SavaMihnea/Security-System/firmware/central-unit/central-unit.ino

/**
 * =============================================================
 * VOXWALL Security System - Central Unit
 * Hardware: ESP32-S3 DevKit
 *
 * Responsibilities:
 *   - Receives sensor events from ESP32-C3 nodes via ESP-NOW
 *   - Forwards events to the Java backend over HTTPS
 *   - Controls siren via relay (GPIO)
 *   - Polls backend every 30 s to sync arm/disarm state
 *   - Runs AI deterrence conversation on alarm (Phase 6)
 *
 * Required libraries (Arduino Library Manager):
 *   - ArduinoJson      (Benoit Blanchon)
 *   - ESP32-audioI2S   (schreibfaul1)    <- for MP3 playback
 *
 * !! Before flashing: update WIFI_SSID, WIFI_PASSWORD,
 *    BACKEND_URL, and ESP_API_KEY below !!
 * =============================================================
 */

#include <WiFi.h>
#include <WiFiClientSecure.h>
#include <HTTPClient.h>
#include <esp_now.h>
#include <SPIFFS.h>
#include <driver/i2s.h>
#include <ArduinoJson.h>
#include "Audio.h"          // ESP32-audioI2S library

// ---- User configuration -----------------------------------------
const char* WIFI_SSID     = "DIGI-2eS3";
const char* WIFI_PASSWORD = "6bZ93ey3tJ";
const char* BACKEND_URL   = "https://voxwall-security.com"; // No trailing slash
const char* ESP_API_KEY   = "pFTF3EJ3MEKx0NE5sO1tAGouPNNeYwJ5CsPAg2zVUXgjevad";
// -----------------------------------------------------------------

// ---- GPIO pins --------------------------------------------------
#define RELAY_SIREN_PIN   10    // Active-LOW relay -> siren
#define RELAY_AUX_PIN     11    // Spare relay
#define RELAY_ON  LOW           // Most relay modules trigger on LOW
#define RELAY_OFF HIGH          // HIGH = relay released (siren off)
#define STATUS_LED_PIN     2    // Status LED

// I2S - MAX98357A amplifier (speaker output, used by ESP32-audioI2S - I2S_NUM_0)
#define I2S_SPK_BCLK     12
#define I2S_SPK_LRC      13
#define I2S_SPK_DOUT     14

// I2S - INMP441 microphone (input, manual driver - I2S_NUM_1)
#define I2S_MIC_SCK       5
#define I2S_MIC_WS        4
#define I2S_MIC_SD        6
// -----------------------------------------------------------------

// ---- Timing constants -------------------------------------------
#define HEARTBEAT_INTERVAL_MS    10000UL  // Sync backend every 10 s (arm mode changes reflect quickly)
#define ENTRY_DELAY_MS           10000UL  // 10 s entry delay for ARMED_AWAY
#define HOME_ENTRY_DELAY_MS       5000UL  // 5 s entry delay for ARMED_HOME (awake, can react faster)
#define PROACTIVE_INTERVAL_MS    12000UL  // Proactive statement every 12 s regardless of mic
#define MIC_RECORD_DURATION_MS    2500UL  // Record 2.5 s per AI interaction (faster response cycle)
#define MIC_AMPLITUDE_THRESHOLD   20000   // Raw I2S peak above = "sound detected"
#define MIC_SAMPLE_RATE           16000   // Hz (Whisper requirement)
// -----------------------------------------------------------------

// ---- Arm mode enum (mirrors backend SystemConfig.ArmMode) -------
enum ArmMode {
    DISARMED,
    ARMED_HOME,         // No sensors processed (home, awake)
    ARMED_HOME_NIGHT,   // All sensors, NO entry delay (home, sleeping)
    ARMED_AWAY          // All sensors + 10-second entry delay on door events
};

// ---- Runtime state ----------------------------------------------
ArmMode       currentArmMode    = DISARMED;
static int32_t mic_dc           = 0;          // persistent DC offset for mic filter
bool          alarmActive       = false;
bool          entryDelayActive  = false;
bool          sirenActive       = false;  // true when Stage 2 (12V relay) is running
unsigned long entryDelayStartMs    = 0;
unsigned long entryDelayDurationMs = ENTRY_DELAY_MS;  // set per-mode when delay starts
char          nodeId[30]        = "CENTRAL_S3";
unsigned long lastHeartbeatMs   = 0;
char          aiSessionId[40]   = "";
bool          audioPreloaded    = false;  // Set when /deterrence.mp3 pre-fetched during entry delay

// Non-blocking ESP-NOW event queue (processing heavy HTTP in loop, not in callback)
volatile bool pendingEvent  = false;
char          pendingNodeId[30];
char          pendingEventType[40];
// -----------------------------------------------------------------

// ---- ESP-NOW message struct (must match sensor-node.ino) --------
typedef struct __attribute__((packed)) SensorMessage {
    char nodeId[30];
    char eventType[40];
    int  sensorValue;
} SensorMessage;

// ---- Audio object (ESP32-audioI2S, uses I2S_NUM_0) --------------
Audio audio;

// =================================================================
// I2S microphone (INMP441, I2S_NUM_1)
// =================================================================
void initMic() {
    i2s_config_t cfg = {
        .mode                 = (i2s_mode_t)(I2S_MODE_MASTER | I2S_MODE_RX),
        .sample_rate          = MIC_SAMPLE_RATE,
        .bits_per_sample      = I2S_BITS_PER_SAMPLE_32BIT, // INMP441: 24-bit in 32-bit slot
        .channel_format       = I2S_CHANNEL_FMT_ONLY_LEFT,
        .communication_format = I2S_COMM_FORMAT_STAND_I2S,
        .intr_alloc_flags     = ESP_INTR_FLAG_LEVEL1,
        .dma_buf_count        = 8,
        .dma_buf_len          = 1024,
        .use_apll             = false
    };
    i2s_pin_config_t pins = {
        .bck_io_num   = I2S_MIC_SCK,
        .ws_io_num    = I2S_MIC_WS,
        .data_out_num = I2S_PIN_NO_CHANGE,
        .data_in_num  = I2S_MIC_SD
    };
    i2s_driver_install(I2S_NUM_1, &cfg, 0, NULL);
    i2s_set_pin(I2S_NUM_1, &pins);
}

// Drain the I2S mic DMA buffer after speaker playback.
// During playMp3() the speaker fills the room with sound; the INMP441 captures
// it into the DMA ring buffer. Without flushing, the next measureMicAmplitude()
// reads that stale speaker audio → false trigger → infinite response loop.
void flushMicBuffer() {
    int32_t sample;
    size_t  bytesRead;
    unsigned long deadline = millis() + 1500UL;  // 1.5 s — covers DMA backlog + room reverb
    while (millis() < deadline) {
        i2s_read(I2S_NUM_1, &sample, sizeof(sample), &bytesRead, pdMS_TO_TICKS(10));
        int32_t val = sample >> 8;
        mic_dc = (mic_dc * 99 + val) / 100;    // keep DC filter tracking during flush
    }
    // DO NOT reset mic_dc — the filter must stay converged so the first
    // measureMicAmplitude() after the flush reads centred samples, not raw DC offset.
    Serial.println("[MIC] Buffer flushed");
}

// Sample 800 frames (~50 ms) with DC filtering and return peak of centred signal.
// 800 samples matches Microphone.ino so the same threshold values apply.
// DC filtering prevents mic bias from inflating the reading.
int32_t measureMicAmplitude() {
    int32_t sample;
    size_t  bytesRead;
    int32_t peak = 0;
    for (int i = 0; i < 800; i++) {
        i2s_read(I2S_NUM_1, &sample, sizeof(sample), &bytesRead, portMAX_DELAY);
        int32_t val = sample >> 8;
        mic_dc = (mic_dc * 99 + val) / 100;    // slow DC filter, same as Microphone.ino
        int32_t centred = val - mic_dc;
        if (abs(centred) > peak) peak = abs(centred);
    }
    return peak;
}

// Record MIC_RECORD_DURATION_MS of audio into SPIFFS as /recording.wav
// Returns total bytes written (0 on failure)
size_t recordToSpiffs() {
    File f = SPIFFS.open("/recording.wav", "w");
    if (!f) {
        Serial.println("[MIC] SPIFFS open failed");
        return 0;
    }

    // Reserve 44 bytes for WAV header; fill after recording
    uint8_t hdr[44] = {0};
    f.write(hdr, 44);

    const int TOTAL_SAMPLES = MIC_SAMPLE_RATE * (MIC_RECORD_DURATION_MS / 1000);
    int32_t rawSample;
    int16_t s16;
    size_t  bytesRead;
    size_t  totalPcm = 0;

    Serial.println("[MIC] Recording...");
    for (int i = 0; i < TOTAL_SAMPLES; i++) {
        i2s_read(I2S_NUM_1, &rawSample, sizeof(rawSample), &bytesRead, portMAX_DELAY);
        s16 = (int16_t)(rawSample >> 16);   // Upper 16 bits -> 16-bit PCM
        f.write((uint8_t*)&s16, 2);
        totalPcm += 2;
    }

    // Write WAV header
    uint32_t dataSize   = (uint32_t)totalPcm;
    uint32_t fileSize   = dataSize + 36;
    uint16_t audioFmt   = 1;
    uint16_t numChan    = 1;
    uint32_t sampleRate = MIC_SAMPLE_RATE;
    uint32_t byteRate   = MIC_SAMPLE_RATE * 2;
    uint16_t blockAlign = 2;
    uint16_t bitsPS     = 16;
    uint32_t subchunk1  = 16;

    f.seek(0);
    f.write((uint8_t*)"RIFF",    4);
    f.write((uint8_t*)&fileSize, 4);
    f.write((uint8_t*)"WAVE",    4);
    f.write((uint8_t*)"fmt ",    4);
    f.write((uint8_t*)&subchunk1, 4);
    f.write((uint8_t*)&audioFmt,  2);
    f.write((uint8_t*)&numChan,   2);
    f.write((uint8_t*)&sampleRate,4);
    f.write((uint8_t*)&byteRate,  4);
    f.write((uint8_t*)&blockAlign,2);
    f.write((uint8_t*)&bitsPS,    2);
    f.write((uint8_t*)"data",  4);
    f.write((uint8_t*)&dataSize,  4);
    f.close();

    Serial.printf("[MIC] Saved %u bytes to /recording.wav\n", totalPcm + 44);
    return totalPcm + 44;
}

// Play an MP3 file from SPIFFS (blocks until playback finishes)
void playMp3(const char* path) {
    File f = SPIFFS.open(path, "r");
    if (!f) {
        Serial.printf("[AUDIO] File not found: %s\n", path);
        return;
    }
    size_t sz = f.size();
    f.close();
    if (sz < 512) {
        Serial.printf("[AUDIO] File too small (%u bytes), skipping: %s\n", sz, path);
        return;
    }
    Serial.printf("[AUDIO] Playing %s (%u bytes)\n", path, sz);
    audio.connecttoFS(SPIFFS, path);
    // Pump several cycles before checking isRunning — the library needs a
    // moment to start decoding or isRunning() returns false immediately
    for (int i = 0; i < 50; i++) { audio.loop(); delay(2); }
    while (audio.isRunning()) {
        audio.loop();
    }
    Serial.println("[AUDIO] Playback complete");
}

// =================================================================
// HTTP helpers
// =================================================================
WiFiClientSecure secureClient;

// POST jsonBody to url; stream MP3 response into SPIFFS destPath
bool postAndSaveMp3(const String& url, const String& jsonBody,
                    const char* sessionId, const char* destPath) {
    Serial.printf("[HTTP] POST %s  session=%s\n", url.c_str(), sessionId ? sessionId : "(none)");
    WiFiClientSecure client;
    client.setInsecure();
    HTTPClient http;
    http.setTimeout(15000);
    http.begin(client, url);
    http.addHeader("Content-Type", "application/json");
    http.addHeader("X-ESP-Key", ESP_API_KEY);
    if (sessionId && sessionId[0] != '\0') {
        http.addHeader("X-Session-Id", sessionId);
    }

    int code = http.POST(jsonBody);
    Serial.printf("[HTTP] Response code: %d  content-length: %d\n", code, http.getSize());
    if (code != 200) {
        String body = http.getString();
        Serial.printf("[HTTP] Error body: %s\n", body.c_str());
        http.end();
        return false;
    }

    File f = SPIFFS.open(destPath, "w");
    if (!f) {
        Serial.printf("[SPIFFS] Failed to open %s for write\n", destPath);
        http.end();
        return false;
    }

    WiFiClient* stream    = http.getStreamPtr();
    int         remaining = http.getSize();
    uint8_t     buf[512];
    size_t      totalWritten = 0;

    while (http.connected() && (remaining > 0 || remaining == -1)) {
        int avail = stream->available();
        if (avail > 0) {
            int n = stream->readBytes(buf, min(avail, (int)sizeof(buf)));
            f.write(buf, n);
            totalWritten += n;
            if (remaining > 0) remaining -= n;
        }
        delay(1);
    }
    f.close();
    http.end();
    Serial.printf("[HTTP] Saved %u bytes to %s\n", totalWritten, destPath);
    return totalWritten > 0;
}

// POST WAV from SPIFFS to /api/ai/respond, save MP3 response
bool postWavAndSaveMp3(const char* sessionId) {
    File wavFile = SPIFFS.open("/recording.wav", "r");
    if (!wavFile) return false;

    size_t   wavSize = wavFile.size();
    uint8_t* wavBuf  = (uint8_t*)malloc(wavSize);
    if (!wavBuf) { wavFile.close(); return false; }
    wavFile.read(wavBuf, wavSize);
    wavFile.close();

    WiFiClientSecure client;
    client.setInsecure();
    HTTPClient http;
    String url = String(BACKEND_URL) + "/api/ai/respond";
    Serial.printf("[HTTP] POST %s  wav=%u bytes  session=%s\n", url.c_str(), wavSize, sessionId);
    http.setTimeout(20000);
    http.begin(client, url);
    http.addHeader("Content-Type", "application/octet-stream");
    http.addHeader("X-ESP-Key", ESP_API_KEY);
    http.addHeader("X-Session-Id", sessionId);

    int code = http.POST(wavBuf, wavSize);
    free(wavBuf);
    Serial.printf("[HTTP] /respond response code: %d  content-length: %d\n", code, http.getSize());

    if (code != 200) {
        String body = http.getString();
        Serial.printf("[HTTP] /respond error body: %s\n", body.c_str());
        http.end();
        return false;
    }

    File mp3 = SPIFFS.open("/response.mp3", "w");
    if (!mp3) { http.end(); return false; }

    WiFiClient* stream    = http.getStreamPtr();
    int         remaining = http.getSize();
    uint8_t     buf[512];

    while (http.connected() && (remaining > 0 || remaining == -1)) {
        int avail = stream->available();
        if (avail > 0) {
            int n = stream->readBytes(buf, min(avail, (int)sizeof(buf)));
            mp3.write(buf, n);
            if (remaining > 0) remaining -= n;
        }
        delay(1);
    }
    mp3.close();
    http.end();
    return true;
}

void sendEventToBackend(const char* fromNodeId, const char* eventType, const char* notes) {
    if (WiFi.status() != WL_CONNECTED) return;

    HTTPClient http;
    String url = String(BACKEND_URL) + "/api/esp/event";
    http.begin(secureClient, url);
    http.addHeader("Content-Type", "application/json");
    http.addHeader("X-ESP-Key", ESP_API_KEY);

    StaticJsonDocument<256> doc;
    doc["nodeId"]    = fromNodeId;
    doc["eventType"] = eventType;
    doc["notes"]     = notes;
    String body;
    serializeJson(doc, body);

    int code = http.POST(body);
    if (code != 200) Serial.printf("[HTTP] event POST -> %d\n", code);
    http.end();
}

void parseStatusResponse(const String& json) {
    StaticJsonDocument<256> doc;
    if (deserializeJson(doc, json) != DeserializationError::Ok) return;

    const char* modeStr = doc["armMode"] | "DISARMED";
    ArmMode newMode = DISARMED;
    if      (strcmp(modeStr, "ARMED_HOME")       == 0) newMode = ARMED_HOME;
    else if (strcmp(modeStr, "ARMED_HOME_NIGHT") == 0) newMode = ARMED_HOME_NIGHT;
    else if (strcmp(modeStr, "ARMED_AWAY")       == 0) newMode = ARMED_AWAY;

    if (newMode != currentArmMode) {
        currentArmMode = newMode;
        Serial.printf("[SYNC] Arm mode -> %s\n", modeStr);
    }
    // Panic button pressed on dashboard — fire siren immediately
    bool panicActive = doc["panicActive"] | false;
    if (panicActive && !alarmActive && !entryDelayActive) {
        Serial.println("[PANIC] Remote panic received — triggering immediate siren");
        triggerNightAlarm(nodeId, "PANIC");
    }
    // Remote disarm cancels alarm and entry delay
    if (currentArmMode == DISARMED && (alarmActive || entryDelayActive)) {
        alarmActive          = false;
        entryDelayActive     = false;
        entryDelayDurationMs = ENTRY_DELAY_MS;
        sirenActive          = false;
        audioPreloaded       = false;
        aiSessionId[0]       = '\0';
        digitalWrite(RELAY_SIREN_PIN, RELAY_OFF);
        Serial.println("[SYNC] Alarm/delay cancelled by remote disarm");
    }
}

void sendHeartbeat() {
    if (WiFi.status() != WL_CONNECTED) return;

    HTTPClient http;
    String url = String(BACKEND_URL) + "/api/esp/heartbeat";
    http.begin(secureClient, url);
    http.addHeader("Content-Type", "application/json");
    http.addHeader("X-ESP-Key", ESP_API_KEY);

    StaticJsonDocument<128> doc;
    doc["nodeId"] = nodeId;
    String body;
    serializeJson(doc, body);

    int code = http.POST(body);
    if (code == 200) parseStatusResponse(http.getString());
    http.end();
}

void registerWithBackend() {
    if (WiFi.status() != WL_CONNECTED) return;

    HTTPClient http;
    String url = String(BACKEND_URL) + "/api/esp/register";
    http.begin(secureClient, url);
    http.addHeader("Content-Type", "application/json");
    http.addHeader("X-ESP-Key", ESP_API_KEY);

    StaticJsonDocument<256> doc;
    doc["nodeId"]   = nodeId;
    doc["name"]     = "Central Unit (ESP32-S3)";
    doc["location"] = "Front Door Panel";
    doc["type"]     = "CENTRAL";
    String body;
    serializeJson(doc, body);

    int code = http.POST(body);
    Serial.printf("[REGISTER] Backend: %d\n", code);
    http.end();
}

// =================================================================
// AI deterrence conversation
// =================================================================
void runAiConversation() {
    Serial.println("============================================================");
    Serial.println("[AI] ===== runAiConversation() ENTERED =====");
    Serial.printf( "[AI] alarmActive=%d  audioPreloaded=%d  sessionId='%s'\n",
                   alarmActive, audioPreloaded, aiSessionId);
    Serial.printf( "[AI] Free heap: %u bytes\n", ESP.getFreeHeap());
    Serial.println("============================================================");

    // Session ID may already be set when audio was pre-fetched during entry delay.
    // Generate a new one only on the immediate-alarm path (no entry delay).
    if (aiSessionId[0] == '\0') {
        snprintf(aiSessionId, sizeof(aiSessionId), "alarm_%lu", millis());
        Serial.printf("[AI] Generated new session ID: %s\n", aiSessionId);
    } else {
        Serial.printf("[AI] Reusing existing session ID: %s\n", aiSessionId);
    }

    // Check pre-fetched file is valid (non-empty); fetch now if not
    if (audioPreloaded) {
        File chk = SPIFFS.open("/deterrence.mp3", "r");
        size_t preloadedSize = chk ? chk.size() : 0;
        if (chk) chk.close();
        Serial.printf("[AI] Pre-fetched /deterrence.mp3 size: %u bytes\n", preloadedSize);
        if (preloadedSize < 512) {
            Serial.println("[AI] Pre-fetched file too small — will re-fetch");
            audioPreloaded = false;
        }
    }

    // Dialogue counter — tracks total AI speeches (opening + proactive + responses).
    // After DIALOGUES_BEFORE_SIREN the loop exits, Stage 2 (12V siren) fires.
    int  aiDialogueCount     = 0;
    const int DIALOGUES_BEFORE_SIREN = 4;

    // ---- STEP 1: Play opening deterrence phrase ----
    Serial.println("[AI] STEP 1 — Fetching/playing opening deterrence phrase");
    if (audioPreloaded) {
        Serial.println("[AI] Using pre-fetched audio");
        playMp3("/deterrence.mp3");
        flushMicBuffer();
        aiDialogueCount++;
        audioPreloaded = false;
    } else {
        Serial.println("[AI] Fetching from /api/ai/alarm-start ...");
        String url = String(BACKEND_URL) + "/api/ai/alarm-start";
        bool ok = postAndSaveMp3(url, "{}", aiSessionId, "/deterrence.mp3");
        Serial.printf("[AI] alarm-start fetch result: %s\n", ok ? "OK" : "FAILED");
        if (ok) {
            Serial.println("[AI] Playing deterrence.mp3...");
            playMp3("/deterrence.mp3");
            Serial.println("[AI] Playback done — flushing mic buffer");
            flushMicBuffer();
            aiDialogueCount++;
        } else {
            Serial.println("[AI] WARNING: Could not fetch opening phrase — skipping to mic loop");
        }
    }
    Serial.printf("[AI] STEP 1 done. dialogues=%d  Free heap: %u bytes\n", aiDialogueCount, ESP.getFreeHeap());

    // Check disarm immediately after the opening phrase (it can block 5-10 s)
    sendHeartbeat(); lastHeartbeatMs = millis();

    // --- Mic monitoring loop ---
    // Every PROACTIVE_INTERVAL_MS the system plays a proactive deterrence statement
    // unconditionally — this fires regardless of ambient noise and eliminates the
    // silence-detection race condition that caused the "first phrase only" bug.
    //
    // In parallel, the mic is still checked: confirmed sustained speech above
    // threshold triggers a record → Whisper → GPT → TTS response cycle.
    // Filtered spikes do NOT reset the proactive timer so spurious noise cannot
    // suppress proactive statements indefinitely.
    unsigned long lastProactiveMs = millis();

    Serial.println("[AI] ===== STEP 2 — Mic monitoring loop started =====");
    Serial.printf("[AI] alarmActive=%d  PROACTIVE_INTERVAL_MS=%lu  THRESHOLD=%d\n",
                  alarmActive, PROACTIVE_INTERVAL_MS, MIC_AMPLITUDE_THRESHOLD);

    while (alarmActive) {
        // Sync arm state with backend every HEARTBEAT_INTERVAL_MS
        if (millis() - lastHeartbeatMs >= HEARTBEAT_INTERVAL_MS) {
            lastHeartbeatMs = millis();
            sendHeartbeat();
            if (!alarmActive) break;
        }

        int32_t amplitude = measureMicAmplitude();
        Serial.printf("[MIC] Amplitude: %d\n", amplitude);

        if (amplitude > MIC_AMPLITUDE_THRESHOLD) {
            // Second reading (~50 ms later) to confirm sustained speech.
            int32_t confirm = measureMicAmplitude();
            if (confirm > MIC_AMPLITUDE_THRESHOLD) {
                Serial.printf("[MIC] Confirmed speech (amp=%d confirm=%d) — recording\n", amplitude, confirm);
                if (recordToSpiffs() > 0 && postWavAndSaveMp3(aiSessionId)) {
                    playMp3("/response.mp3");
                    flushMicBuffer();
                    aiDialogueCount++;
                    lastProactiveMs = millis();  // Full response handled — reset proactive timer
                }
                // Heartbeat right after this long blocking sequence for fast disarm response
                sendHeartbeat(); lastHeartbeatMs = millis();
                if (!alarmActive) break;
                if (!sirenActive && aiDialogueCount >= DIALOGUES_BEFORE_SIREN) {
                    sirenActive = true;
                    digitalWrite(RELAY_SIREN_PIN, RELAY_ON);
                    Serial.printf("[ALARM] Stage 2: Siren ON after %d dialogues — exiting AI loop\n", aiDialogueCount);
                    break;  // Stop AI — Stage 2 takes over
                }
            } else {
                Serial.printf("[MIC] Spike filtered (amp=%d confirm=%d)\n", amplitude, confirm);
                // Filtered spikes do NOT reset lastProactiveMs
            }
        }

        // Fixed-interval proactive — fires every PROACTIVE_INTERVAL_MS unconditionally
        if (millis() - lastProactiveMs >= PROACTIVE_INTERVAL_MS) {
            Serial.println("[AI] ===== Proactive interval reached — fetching statement =====");
            Serial.printf("[AI] Free heap before fetch: %u bytes\n", ESP.getFreeHeap());
            String proactiveUrl = String(BACKEND_URL) + "/api/ai/proactive";
            bool ok = postAndSaveMp3(proactiveUrl, "{}", aiSessionId, "/proactive.mp3");
            Serial.printf("[AI] Proactive fetch result: %s\n", ok ? "OK" : "FAILED");
            if (ok) {
                Serial.println("[AI] Playing proactive.mp3...");
                playMp3("/proactive.mp3");
                Serial.println("[AI] Proactive playback done — flushing mic");
                flushMicBuffer();
                aiDialogueCount++;
            }
            lastProactiveMs = millis();
            // Heartbeat right after this long blocking sequence for fast disarm response
            sendHeartbeat(); lastHeartbeatMs = millis();
            if (!alarmActive) break;
            if (!sirenActive && aiDialogueCount >= DIALOGUES_BEFORE_SIREN) {
                sirenActive = true;
                digitalWrite(RELAY_SIREN_PIN, RELAY_ON);
                Serial.printf("[ALARM] Stage 2: Siren ON after %d dialogues — exiting AI loop\n", aiDialogueCount);
                break;  // Stop AI — Stage 2 takes over
            }
        }
        // No extra delay — measureMicAmplitude() already takes ~50 ms per call
    }
    // ---------------------------
    Serial.println("[AI] ===== Mic monitoring loop EXITED =====");
    Serial.printf("[AI] alarmActive=%d  sirenActive=%d  dialogues=%d\n",
                  alarmActive, sirenActive, aiDialogueCount);

    // Notify backend so the dashboard switches the banner to "ALARM ACTIVE"
    if (sirenActive && alarmActive) {
        sendEventToBackend(nodeId, "SIREN_ACTIVE", "Stage 2 siren started");
    }

    aiSessionId[0] = '\0';
    Serial.println("[AI] Conversation ended — Stage 2 running");
}

// =================================================================
// Alarm control
// =================================================================
void triggerAlarm(const char* sourceNodeId, const char* eventType) {
    if (alarmActive) return;

    alarmActive      = true;
    entryDelayActive = false;
    // Relay stays OFF — Stage 2 (siren) fires inside runAiConversation() after
    // DIALOGUES_BEFORE_SIREN AI speeches. Disarming before that keeps it silent.
    Serial.println("[ALARM] TRIGGERED — Stage 1 (AI) starting");
    sendEventToBackend(sourceNodeId, "ALARM_TRIGGERED", eventType);

    runAiConversation();  // Stage 1: AI talks, exits after 5 dialogues OR disarm

    // Stage 2: siren is running — poll heartbeats until user presses Terminate Alert
    if (alarmActive) {
        Serial.println("[ALARM] Stage 2: Siren running — waiting for disarm");
        // Immediate check: catch disarms that happened during AI phase
        sendHeartbeat(); lastHeartbeatMs = millis();
        while (alarmActive) {
            // Poll every 2 s so Terminate Alert stops the siren quickly
            if (millis() - lastHeartbeatMs >= 2000UL) {
                lastHeartbeatMs = millis();
                sendHeartbeat();
            }
            delay(100);
        }
        Serial.println("[ALARM] Stage 2: Disarmed — stopping siren");
    }

    // Cleanup — relay off, state reset
    sirenActive = false;
    digitalWrite(RELAY_SIREN_PIN, RELAY_OFF);
}

void triggerNightAlarm(const char* sourceNodeId, const char* eventType) {
    if (alarmActive) return;

    alarmActive      = true;
    entryDelayActive = false;
    Serial.println("[ALARM] NIGHT MODE — immediate siren (no AI)");
    sendEventToBackend(sourceNodeId, "ALARM_TRIGGERED", eventType);
    digitalWrite(RELAY_SIREN_PIN, RELAY_ON);
    sirenActive = true;
    sendEventToBackend(nodeId, "SIREN_ACTIVE", "Night mode: immediate siren");

    sendHeartbeat(); lastHeartbeatMs = millis();
    while (alarmActive) {
        if (millis() - lastHeartbeatMs >= 2000UL) {
            lastHeartbeatMs = millis();
            sendHeartbeat();
        }
        delay(100);
    }

    sirenActive = false;
    digitalWrite(RELAY_SIREN_PIN, RELAY_OFF);
}

void stopAlarm() {
    alarmActive      = false;
    entryDelayActive = false;
    digitalWrite(RELAY_SIREN_PIN, RELAY_OFF);
    Serial.println("[ALARM] Stopped");
    sendEventToBackend(nodeId, "ALARM_DISARMED", "Remote disarm");
}

// =================================================================
// Sensor event handler - applies arm mode logic and entry delay
// =================================================================
bool isDoorEvent(const char* eventType) {
    return strcmp(eventType, "DOOR_OPENED") == 0 ||
           strcmp(eventType, "DOOR_CLOSED")  == 0;
}

void registerOtherNode(const char* targetNodeId, const char* name, const char* location, const char* type) {
    if (WiFi.status() != WL_CONNECTED) return; //

    HTTPClient http;
    String url = String(BACKEND_URL) + "/api/esp/register"; //
    http.begin(secureClient, url); //
    http.addHeader("Content-Type", "application/json");
    http.addHeader("X-ESP-Key", ESP_API_KEY); //

    StaticJsonDocument<256> doc;
    doc["nodeId"]   = targetNodeId;
    doc["name"]     = name;
    doc["location"] = location;
    doc["type"]     = type; //

    String body;
    serializeJson(doc, body);

    int code = http.POST(body); //
    Serial.printf("[REG-OTHER] Node %s: %d\n", targetNodeId, code);
    http.end();
}

void handleSensorEvent(const char* fromNodeId, const char* eventType) {
    // NODE_ONLINE_<TYPE> is sent by each sensor on boot so the gateway can register it
    // with the correct name, location, and type.  The type suffix was added so multiple
    // sensor types are not all registered as "Front Door Sensor / DOOR".
    if (strncmp(eventType, "NODE_ONLINE", 11) == 0) {
        const char* suffix   = eventType + 11;   // "" or "_DOOR" or "_VIBRATION" or "_MOTION"
        const char* regName;
        const char* regLoc;
        const char* regType;
        if (strcmp(suffix, "_VIBRATION") == 0) {
            regName = "Window Vibration"; regLoc = "Living Room"; regType = "VIBRATION";
        } else if (strcmp(suffix, "_MOTION") == 0) {
            regName = "Front Door Motion"; regLoc = "Entrance"; regType = "MOTION";
        } else {
            regName = "Front Door Sensor"; regLoc = "Entrance"; regType = "DOOR";
        }
        registerOtherNode(fromNodeId, regName, regLoc, regType);
        sendEventToBackend(fromNodeId, "NODE_ONLINE", "");  // normalised — backend enum has NODE_ONLINE
        return;
    }

    // Always log the raw event for dashboard history
    sendEventToBackend(fromNodeId, eventType, "");

    switch (currentArmMode) { //

        case DISARMED:
            break;

        case ARMED_HOME:
            // Motion ignored — family moving around inside
            if (strcmp(eventType, "MOTION_DETECTED") == 0) break;
            if (alarmActive) break;
            if (!entryDelayActive) {
                entryDelayActive     = true;
                entryDelayStartMs    = millis();
                entryDelayDurationMs = HOME_ENTRY_DELAY_MS;
                Serial.println("[ENTRY DELAY] 5 seconds to disarm (Armed Home)...");
                sendEventToBackend(nodeId, "ALARM_TRIGGERED", "Entry delay started");
            }
            break;

        case ARMED_HOME_NIGHT:
            // Motion is LOG_ONLY — occupants are asleep inside, not intruders
            if (strcmp(eventType, "MOTION_DETECTED") == 0) break;
            // Door or vibration: skip AI entirely, activate siren immediately
            if (!alarmActive) triggerNightAlarm(fromNodeId, eventType);
            break;

        case ARMED_AWAY:
            if (alarmActive) break;

            if (!entryDelayActive) {
                // Every sensor type gets the 10-second entry delay in ARMED_AWAY.
                // This gives the owner time to disarm and shows the countdown on the dashboard.
                entryDelayActive     = true;
                entryDelayStartMs    = millis();
                entryDelayDurationMs = ENTRY_DELAY_MS;
                Serial.println("[ENTRY DELAY] 10 seconds to disarm...");
                sendEventToBackend(nodeId, "ALARM_TRIGGERED", "Entry delay started");

                // Pre-fetch TTS audio now so it plays the instant the countdown ends.
                snprintf(aiSessionId, sizeof(aiSessionId), "alarm_%lu", millis());
                Serial.println("[AI] Pre-fetching alarm audio during entry delay...");
                String aiUrl = String(BACKEND_URL) + "/api/ai/alarm-start";
                audioPreloaded = postAndSaveMp3(aiUrl, "{}", aiSessionId, "/deterrence.mp3");
                if (audioPreloaded) Serial.println("[AI] Alarm audio ready.");
                else                Serial.println("[AI] Pre-fetch failed, will retry at alarm start.");
            }
            break;
    }
}

// =================================================================
// ESP-NOW callback - store event, process safely in loop()
// =================================================================
void onDataReceived(const uint8_t* mac_addr, const uint8_t* data, int len) {
    if (pendingEvent) return;   // Drop if we haven't processed the previous event yet

    SensorMessage msg;
    memcpy(&msg, data, sizeof(msg));

    strncpy(pendingNodeId,    msg.nodeId,    sizeof(pendingNodeId)    - 1);
    strncpy(pendingEventType, msg.eventType, sizeof(pendingEventType) - 1);
    pendingNodeId[sizeof(pendingNodeId) - 1]       = '\0';
    pendingEventType[sizeof(pendingEventType) - 1] = '\0';

    pendingEvent = true;

    Serial.printf("[ESP-NOW] Node: %s  Event: %s  Value: %d\n",
                  msg.nodeId, msg.eventType, msg.sensorValue);
}

// =================================================================
// Setup
// =================================================================
void setup() {
    Serial.begin(115200);
    delay(500);

    // Pre-load output registers before switching to OUTPUT to prevent boot glitch
    digitalWrite(RELAY_SIREN_PIN, RELAY_OFF);
    digitalWrite(RELAY_AUX_PIN,   RELAY_OFF);
    pinMode(RELAY_SIREN_PIN, OUTPUT);
    pinMode(RELAY_AUX_PIN,   OUTPUT);
    pinMode(STATUS_LED_PIN,  OUTPUT);

    // Init SPIFFS for WAV/MP3 temporary files
    if (!SPIFFS.begin(true)) {
        Serial.println("[SPIFFS] Mount failed!");
    } else {
        Serial.printf("[SPIFFS] Mounted (free: %u bytes)\n", SPIFFS.totalBytes() - SPIFFS.usedBytes());
    }

    // Connect to Wi-Fi (AP+STA required to use ESP-NOW + WiFi simultaneously)
    WiFi.mode(WIFI_AP_STA);
    WiFi.begin(WIFI_SSID, WIFI_PASSWORD);

    Serial.print("[WiFi] Connecting");
    while (WiFi.status() != WL_CONNECTED) {
        delay(500);
        Serial.print(".");
    }
    Serial.println("\n[WiFi] " + WiFi.localIP().toString());

    // Stable node ID from MAC address
    String mac = WiFi.macAddress();
    mac.replace(":", "");
    ("CENTRAL_" + mac).toCharArray(nodeId, sizeof(nodeId));
    Serial.printf("[ID] %s\n", nodeId);

    // HTTPS: skip cert verification in dev/demo
    // TODO: pin the Railway/Render cert before final deployment
    secureClient.setInsecure();

    // Init I2S microphone (INMP441, I2S_NUM_1)
    initMic();
    Serial.println("[I2S] Mic ready on I2S_NUM_1");

    // Init I2S speaker (MAX98357A, I2S_NUM_0 via ESP32-audioI2S)
    audio.setPinout(I2S_SPK_BCLK, I2S_SPK_LRC, I2S_SPK_DOUT);
    audio.setVolume(21);    // 0-21, max — TTS voice audio well within USB supply limits
    Serial.println("[I2S] Speaker ready on I2S_NUM_0");

    // Init ESP-NOW
    if (esp_now_init() != ESP_OK) {
        Serial.println("[ESP-NOW] Init FAILED!");
        return;
    }
    esp_now_register_recv_cb(onDataReceived);
    Serial.println("[ESP-NOW] Ready");

    // Register and sync initial state
    registerWithBackend();
    sendHeartbeat();
    lastHeartbeatMs = millis();

    digitalWrite(STATUS_LED_PIN, HIGH);
    Serial.println("[VOXWALL] Central unit ready.");
}

// =================================================================
// Loop - non-blocking task runner
// =================================================================
void loop() {
    unsigned long now = millis();

    // Process any queued ESP-NOW event
    if (pendingEvent && !alarmActive) {
        pendingEvent = false;
        handleSensorEvent(pendingNodeId, pendingEventType);
    }

    // Entry delay countdown (ARMED_AWAY, door triggered)
    if (entryDelayActive && !alarmActive) {
        // Fast LED blink during countdown
        digitalWrite(STATUS_LED_PIN, (now / 200) % 2);

        if (now - entryDelayStartMs >= entryDelayDurationMs) {
            Serial.println("[ENTRY DELAY] Expired - triggering alarm");
            entryDelayActive = false;
            if (currentArmMode == ARMED_HOME) {
                triggerNightAlarm(nodeId, "DOOR_OPENED");
            } else {
                triggerAlarm(nodeId, "DOOR_OPENED");
            }
        }
        return;     // Skip heartbeat while counting down (will resume after)
    }

    // Periodic backend heartbeat
    if (now - lastHeartbeatMs >= HEARTBEAT_INTERVAL_MS) {
        lastHeartbeatMs = now;
        sendHeartbeat();
    }

    // Status LED patterns
    if (alarmActive) {
        digitalWrite(STATUS_LED_PIN, (now / 250) % 2);   // Fast blink = alarm
    } else if (currentArmMode != DISARMED) {
        digitalWrite(STATUS_LED_PIN, HIGH);               // Solid = armed
    } else {
        digitalWrite(STATUS_LED_PIN, (now / 2000) % 2);  // Slow pulse = disarmed
    }

    delay(50);
}
