SavaMihnea/Security-System/backend/src/main/java/com/securitysystem/config/SecurityConfig.java

package com.securitysystem.config;

import com.securitysystem.security.JwtAuthFilter;
import lombok.RequiredArgsConstructor;
import org.springframework.context.annotation.Bean;
import org.springframework.context.annotation.Configuration;
import org.springframework.security.authentication.AuthenticationManager;
import org.springframework.security.config.annotation.authentication.configuration.AuthenticationConfiguration;
import org.springframework.security.config.annotation.method.configuration.EnableMethodSecurity;
import org.springframework.security.config.annotation.web.builders.HttpSecurity;
import org.springframework.security.config.annotation.web.configuration.EnableWebSecurity;
import org.springframework.security.config.annotation.web.configurers.AbstractHttpConfigurer;
import org.springframework.security.config.http.SessionCreationPolicy;
import org.springframework.security.crypto.bcrypt.BCryptPasswordEncoder;
import org.springframework.security.crypto.password.PasswordEncoder;
import org.springframework.beans.factory.annotation.Value;
import org.springframework.security.web.SecurityFilterChain;
import org.springframework.security.web.authentication.UsernamePasswordAuthenticationFilter;
import org.springframework.web.cors.CorsConfiguration;
import org.springframework.web.cors.CorsConfigurationSource;
import org.springframework.web.cors.UrlBasedCorsConfigurationSource;

import java.util.List;

@Configuration
@EnableWebSecurity
@EnableMethodSecurity
@RequiredArgsConstructor
public class SecurityConfig {

    private final JwtAuthFilter jwtAuthFilter;

    @Value("${cors.allowed-origin:http://localhost:8080}")
    private String allowedOrigin;

    @Bean
    public SecurityFilterChain filterChain(HttpSecurity http) throws Exception {
        http
            .cors(cors -> cors.configurationSource(corsConfigurationSource()))
            .csrf(AbstractHttpConfigurer::disable)
            .sessionManagement(session ->
                session.sessionCreationPolicy(SessionCreationPolicy.STATELESS))
            .authorizeHttpRequests(auth -> auth
                // Only the login endpoint is public — all other /api/auth/** require a valid JWT
                .requestMatchers("/api/auth/login").permitAll()
                // ESP32 nodes authenticate with X-ESP-Key header (checked inside controllers)
                .requestMatchers("/api/esp/**").permitAll()
                // AI audio endpoints called from ESP32
                .requestMatchers("/api/ai/alarm-start", "/api/ai/proactive", "/api/ai/respond").permitAll()
                // WebSocket handshake
                .requestMatchers("/ws/**").permitAll()
                // Static frontend files served by Spring Boot
                .requestMatchers("/", "/index.html", "/login.html", "/dashboard.html",
                                 "/sensors.html", "/events.html", "/about.html", "/help.html",
                                 "/assets/**", "/logo.png", "/favicon.ico",
                                 "/login", "/dashboard", "/sensors", "/events", "/about", "/help").permitAll()
                // Everything else requires a valid JWT
                .anyRequest().authenticated()
            )
            .addFilterBefore(jwtAuthFilter, UsernamePasswordAuthenticationFilter.class);

        return http.build();
    }

    @Bean
    public CorsConfigurationSource corsConfigurationSource() {
        CorsConfiguration config = new CorsConfiguration();
        // Locked to the configured origin — set cors.allowed-origin in application.properties
        // to your Railway/Render URL before deploying.
        config.setAllowedOriginPatterns(List.of(allowedOrigin));
        config.setAllowedMethods(List.of("GET", "POST", "PUT", "DELETE", "OPTIONS"));
        config.setAllowedHeaders(List.of("*"));
        config.setAllowCredentials(true);
        UrlBasedCorsConfigurationSource source = new UrlBasedCorsConfigurationSource();
        source.registerCorsConfiguration("/**", config);
        return source;
    }

    @Bean
    public PasswordEncoder passwordEncoder() {
        return new BCryptPasswordEncoder();
    }

    @Bean
    public AuthenticationManager authenticationManager(AuthenticationConfiguration config) throws Exception {
        return config.getAuthenticationManager();
    }
}
