SavaMihnea/Security-System/(commit log)

2026-04-05 Initial commit: Spring Boot backend, firmware, Dockerfile, cloud-ready config
2026-04-28 timer display
2026-04-29 Sensor updates + siren logic
2026-04-29 Alarm fix + dashboard logic
    [central-unit.ino]
2026-05-07 UI changes + arm modes logic solved
    [AuthService.java, SecurityConfig.java]
2026-05-08 Panic button
